fusex/parachute_sequencer/docs/sequenceur_de_vol_analogique_V2.pdf

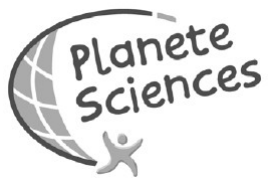
[picture p1: figure]
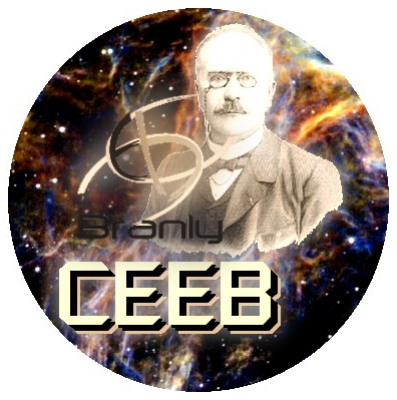
[picture p2: figure]

# SÉQUENCEUR DE VOL ANALOGIQUE

V2.0

# (Simple alimentation12V)

### Club Espace Édouard Branly Châtellerault

24/01/14 | 1/8 | CEEB

Le séquenceur de vol suivant offre une solution simple aux équipes éprouvant des difficultés à répondre aux exigences du cahier des charges.

Câblage (voir annexe)

Le connecteur JACK DEP NF est relié à un contact qui doit être normalement fermé lorsque la fiche jack mâle est insérée.

Le connecteur JACK M/A est relié à un contact qui doit être normalement fermé lorsque la fiche jack mâle est insérée.

Le connecteur ALIM 12V est connecté à une pile ou un accumulateur 12V .

Le connecteur ELECTRO AIMANT PERMANENT doit être relié à un électroaimant permanent 12V.

Le choix de la capacité de votre pile dépend essentiellement de la consommation de l'électroaimant. Le séquenceur consomme 120µA à l'arrêt ! Et oui il consomme lorsque la jack M/A est insérée. Si votre pile à une capacité de 1Ah le séquenceur à l'arrêt en viendra à bout en 8300 heures , soit un peu moins d'un an !

En position marche (jack M/A retirée) le séquenceur consomme 16,4 mA ; en vol 23mA et 520 mA lorsque notre électroaimant est actionné.

24/01/14 | 2/8 | CEEB

## Fonctionnement

Position de transport et stockage : JACK M/A et Jack DEP en place

Fusée en rampe : JACK M/A et Jack DEP en place – fil d'accrochage de Jack DEP fixé à la rampe

Sur consigne de mise en marche du responsable du tir JACK M/A enlevée – Jack DEP en place et fixée à la rampe
La fusée est prête au départ.

La suite des événements ...

La tension de sortie de
l'amplificateur
opérationnel (AOP) ; notée Us peut prendre deux
valeurs :

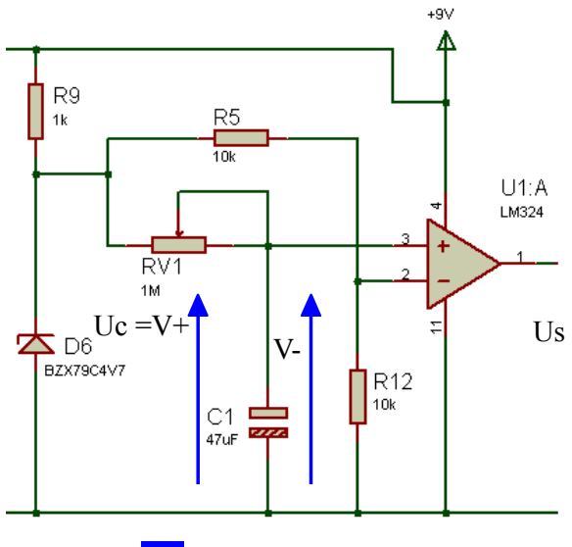
[picture p3: figure]

12V si V+ est supérieure V- ou 0V si V+ est inférieure à V-. V+ et V- sont respectivement les tensions ou différences de potentiels (ddp) des entrées + et – de l'AOP .

V- est constante car c'est la moitié de la ddp aux bornes d'une diode Zener. Ce composant maintien constante la tension à ses bornes ; ici 4,7V ; V- = 2,35V

V+ est la ddp aux bornes de C1 ; et pour le moment (jack DEP en place) cette tension est nulle car jack DEP (non représentée) place C1 en court circuit.

V+ étant inférieure à V- ; la tension de sortie vaut 0V ou presque et l'actionneur n'est pas alimenté.

J ACK DEP arrachée par le départ de la fusée

Le condensateur C1 de 47 µF (micro Farads) se charge à travers RV1 (max 1MΩ) et la ddp Uc à ses bornes augmente. Ça nous donne ça !

24/01/14 | 3/8 | CEEB

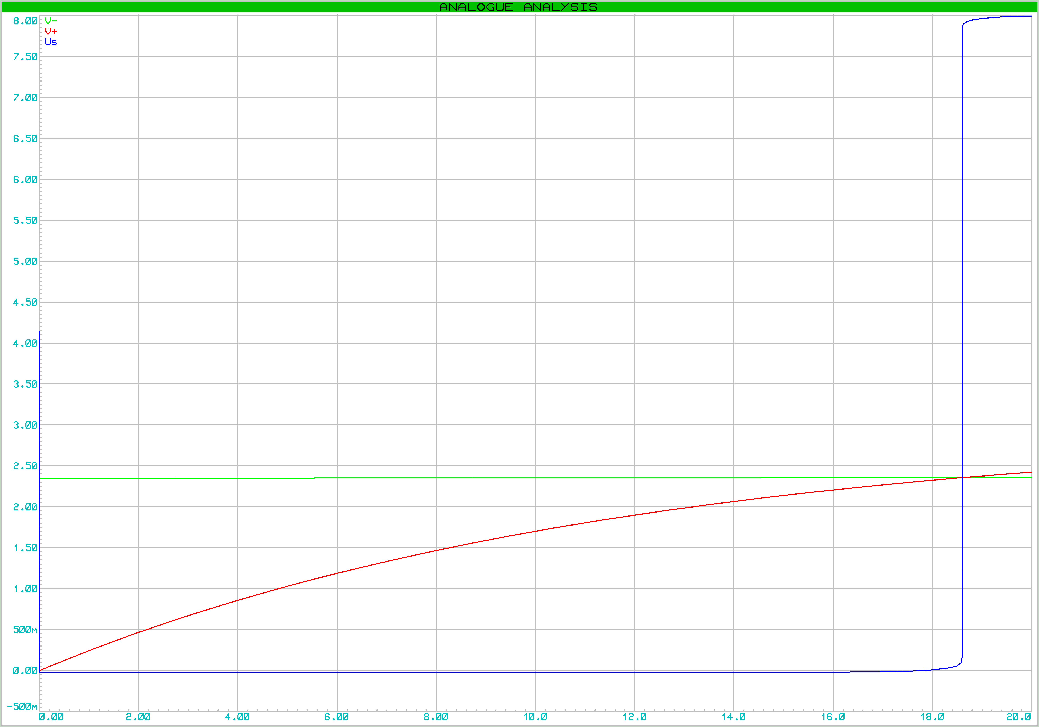
[picture p4: figure]

On ne s’enfuit pas en courant ; tout va bien.

Le tracé vert c'est V- = 2,35V ; c'est une constante c'est facile.
Le tracé bleu c'est la sortie Us ; on y revient juste après. Donc le tracé rouge c'est ?... c'est ? Ben c'est Uc ou V+ (c'est la même) !

Uc augmente car C ce charge à travers RV1. Cette charge est exponentielle : Uc=4,7(1−e

−t
RV1xC1 )
« 4,7 », c'est la tension d'alimentation du circuit RC et t le temps en seconde.

Tant que Uc est inférieure à 2,35V ; la tension de sortie est nulle et l'actionneur n'est pas alimenté. Dès que Uc est supérieure à 2,35V la tension de sortie est de 11V (le graphe indique 8V mais c'est pas grave) et l'actionneur est alimenté. Pourquoi 11V ? Parce que l'AOP, ici un LM324 (pas cher et répandu), n'est pas capable de fournir en sortie une tension égale à ses alimentations. Certains AOP sont capables d'accepter en entrée et de fournir en sortie des valeurs max atteignant leur tensions d'alimentation ; on dit que se sont des AOP « rail to rail ».

Sur le graphe la bascule se fait un peu avant 15 secondes ; c'est la valeur pour RV1 réglée à la moitié de sa course (500kΩ).

Il peut être avantageux de placer une résistance fixe (non variable) à la place de RV1. Le calcul de RV1 est le suivant :

Pour Uc= 2,35V ; t=15sec ; C1 = 47 µF on obtient R = 460kΩ

24/01/14 | 4/8 | CEEB

RV1=

−t
C1

.ln (1−

Uc
4,7 )

Calcul de la durée de temporisation | :

L'étage de sortie

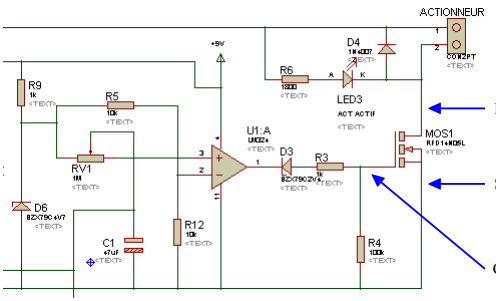
[picture p5: figure]

Lorsque la tension de sortie est nulle le MOSFET n'est pas commandé. D3 permet de lutter contre de faibles variations autour du 0V, R3 évite (amortit) les oscillations du circuit RC composé de la résistance des fils et de la grille du MOSFET lorsque ce dernier est commandé et qu'un fort courant drain source s'installe dans le MOSFET ; enfin R4 est un PULL DOWN ou rappel de tension nulle qui nous assure que la grille du MOSFET est toujours soumise à un potentiel nul en l'absence de tension de sortie de l'AOP et ce quelle qu'en soit la raison.

D4 est une diode de roue libre ; elle permet à l'énergie stockée dans la bobine de votre actionneur de se dissiper sans risque pour le MOSFET.

Finalement LED3 génère le signal lumineux informant que l'actionneur est actif (voir cahier des charges).
Dans ce registre ; LED1 informe que le séquenceur est actif alors que LED2 informe que la fusée a décollé.

Ces trois informations sont des exigences du cahier des charges.

Pour toutes informations complémentaires, contacter le responsable du club. frederic.douguet@ac-poitiers.fr

24/01/14 | 5/8 | CEEB

Drain

Source

Grille

t=−RV1 .47.10⁻⁶
.ln(1−

2,35
4,7

)

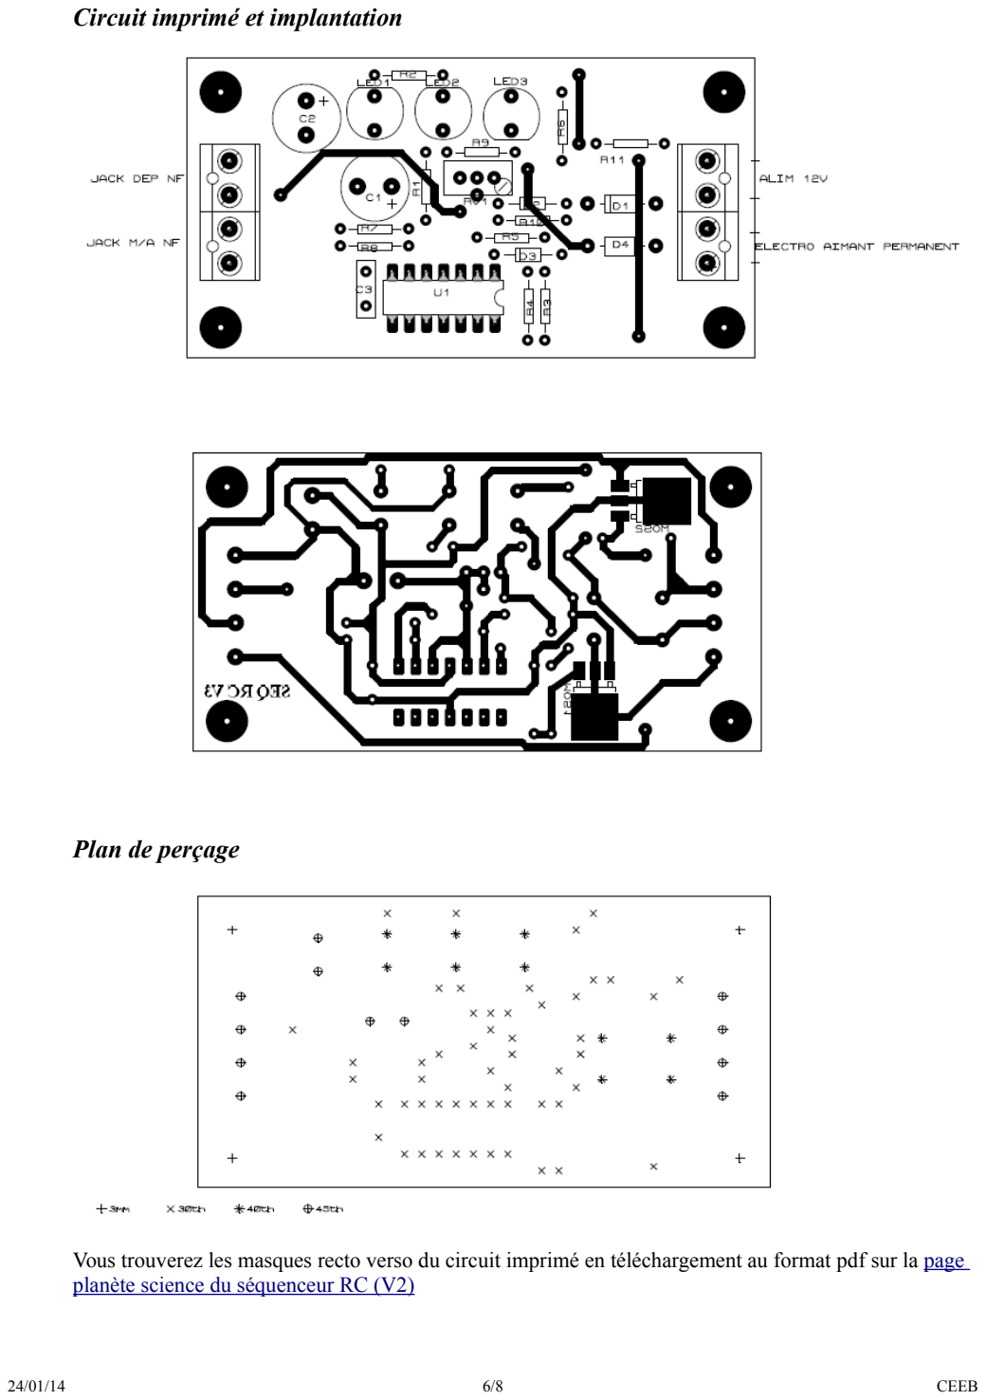
[picture p6: page 6]

Circuit imprimé et implantation

Plan de perçage

Vous trouverez les masques recto verso du circuit imprimé en téléchargement au format pdf sur la page planète science du séquenceur RC (V2) (http://www.planete-sciences.org/espace/basedoc/S%C3%A9quenceur_analogique_%C3%A0_circuit_RC)

24/01/14 | 6/8 | CEEB

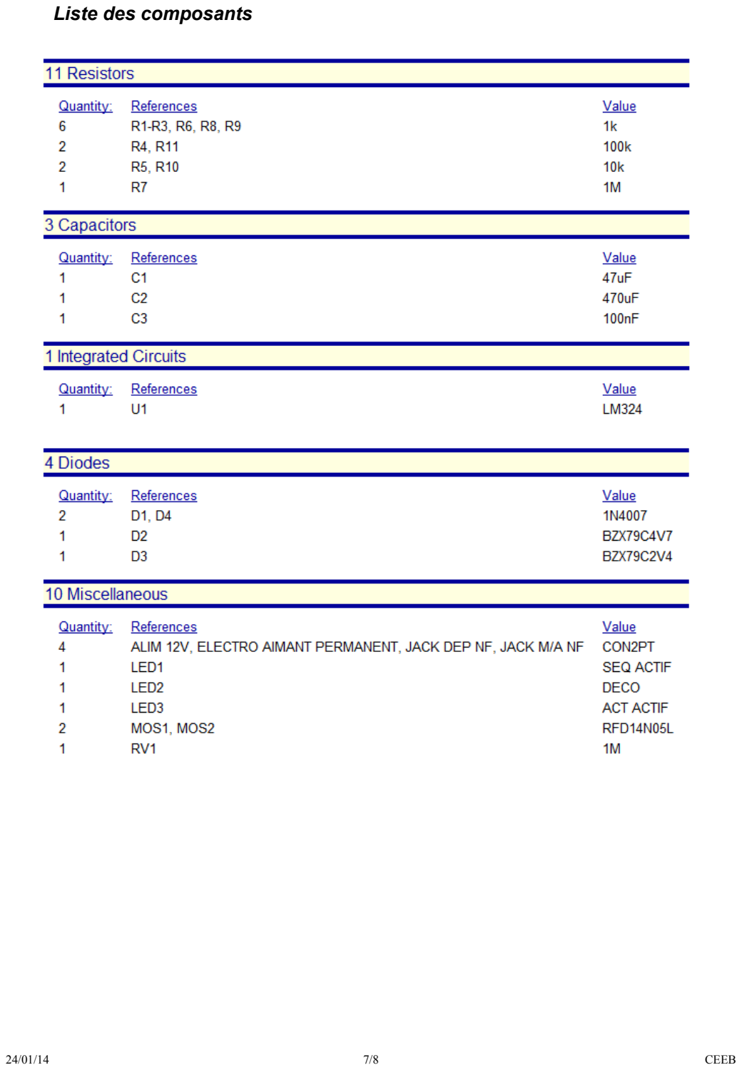
[picture p7: page 7]

Liste des composants

24/01/14 | 7/8 | CEEB

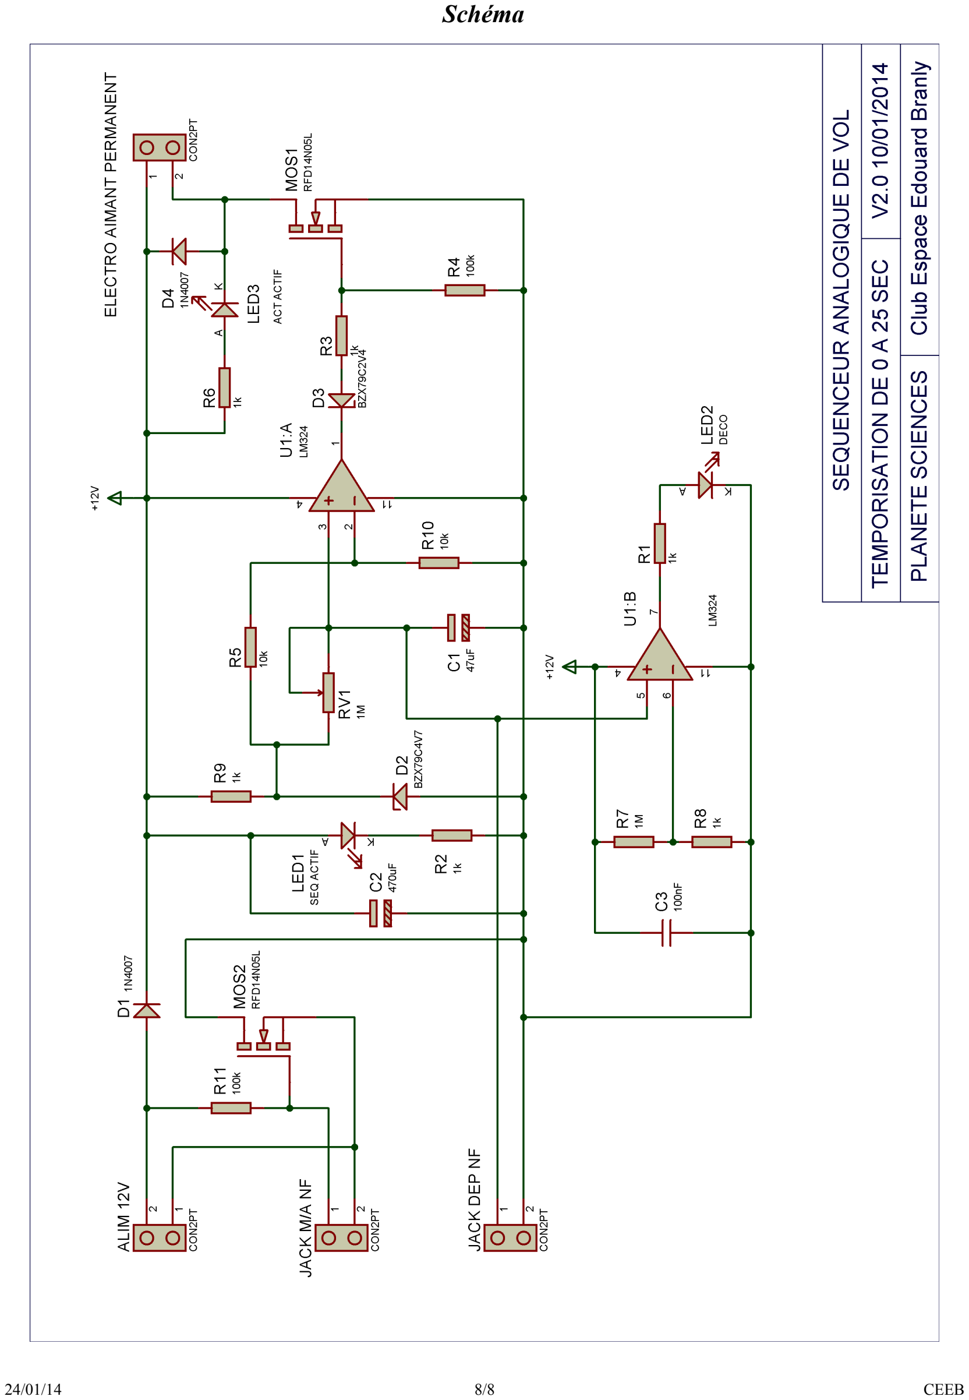
[picture p8: page 8]

Schéma

24/01/14 | 8/8 | CEEB
