fusex/parachute_sequencer/sequenceur-fusex.sch

## KiCad design sequenceur-fusex.sch (2020-12-20)

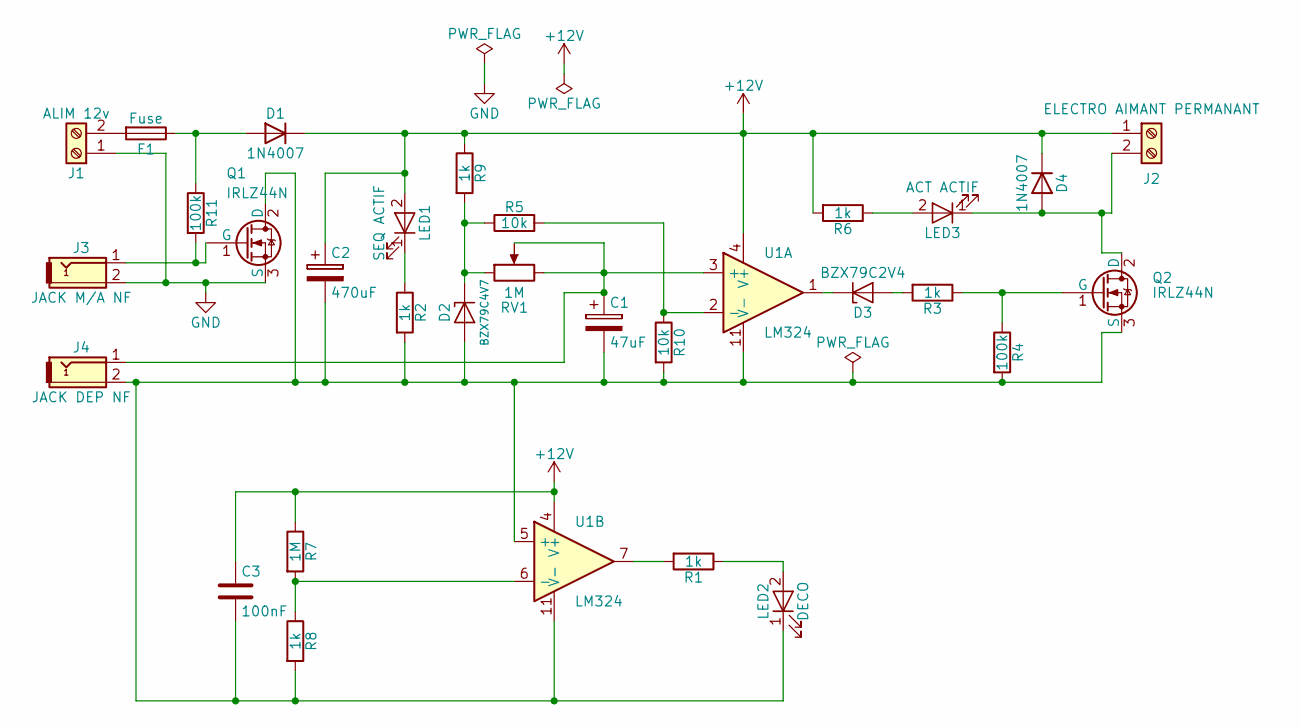
[picture p9: schematic sequenceur-fusex.sch]

Parts:
C1: 47uF; CP_Elec_6.3x5.8
C2: 470uF; CP_Elec_10x10.5
C3: 100nF; C_0805_2012Metric_Pad1.18x1.45mm_HandSolder
D1, D4: 1N4007; D_SMA_Handsoldering
D2: BZX79C4V7; D_SOD-523
D3: BZX79C2V4; D_SOD-123
F1: Fuse; Fuse_Littelfuse-NANO2-451_453
J1: ALIM 12v; TerminalBlock_bornier-2_P5.08mm
J2: ELECTRO AIMANT PERMANANT; TerminalBlock_bornier-2_P5.08mm
J3: JACK M/A NF; TerminalBlock_bornier-2_P5.08mm
J4: JACK DEP NF; TerminalBlock_bornier-2_P5.08mm
LED1: SEQ ACTIF; LED_0805_2012Metric_Pad1.15x1.40mm_HandSolder
LED2: DECO; LED_0805_2012Metric_Pad1.15x1.40mm_HandSolder
LED3: ACT ACTIF; LED_0805_2012Metric_Pad1.15x1.40mm_HandSolder
Q1, Q2: IRLZ44N; TO-263-3_TabPin2
R1, R2, R3, R6, R8, R9: 1k; R_0805_2012Metric_Pad1.20x1.40mm_HandSolder
R4, R11: 100k; R_0805_2012Metric_Pad1.20x1.40mm_HandSolder
R5, R10: 10k; R_0805_2012Metric_Pad1.20x1.40mm_HandSolder
R7: 1M; R_0805_2012Metric_Pad1.20x1.40mm_HandSolder
RV1: 1M; 3313J1102E
U1: LM324; SOIC-14_3.9x8.7mm_P1.27mm

Connections:
+12V: C2.1, C3.1, D1.1 (K), D4.1 (K), J2.1, LED1.2 (A), R6.2, R7.1, R9.1, U1.4 (V+)
GND: J1.1, J3.2, Q1.3 (S)
unnamed: C1.1, J4.1, RV1.2, RV1.3, U1.3 (+)
unnamed: C1.2, C2.2, C3.2, D2.2 (A), J4.2, LED2.1 (K), Q1.2 (D), Q2.3 (S), R2.2, R4.2, R8.2, R10.2, U1.5 (+), U1.11 (V-)
unnamed: D1.2 (A), F1.1, R11.1
unnamed: D2.1 (K), R5.1, R9.2, RV1.1
unnamed: D3.1 (K), U1.1
unnamed: D3.2 (A), R3.2
unnamed: D4.2 (A), J2.2, LED3.1 (K), Q2.2 (D)
unnamed: F1.2, J1.2
unnamed: J3.1, Q1.1 (G), R11.2
unnamed: LED1.1 (K), R2.1
unnamed: LED2.2 (A), R1.1
unnamed: LED3.2 (A), R6.1
unnamed: Q2.1 (G), R3.1, R4.1
unnamed: R1.2, U1.7
unnamed: R7.2, R8.1, U1.6 (-)
unnamed: R5.2, R10.1, U1.2 (-)
