fusex/parachute_sequencer/(commit log)

2018-05-22 initial commit containing draft v0.1
    [sequenceur-fusex.kicad_pcb, sequenceur-fusex.sch]
2018-05-27 inlarge power tracks + add text
    [sequenceur-fusex.kicad_pcb]
2018-06-06 add a fuse and enlarge some track
    [sequenceur-fusex.kicad_pcb, sequenceur-fusex.sch]
2020-12-20 select smt instead of though-holes
    update symbol and cache file for kicadv5
    delete net list
    [sequenceur-fusex.kicad_pcb, sequenceur-fusex.sch]
