fusex/parachute_sequencer/(notices)

Notices in the files:
sequenceur-fusex.sch:
License: GPL
